Achllle/open-source-rover/Electrical/Latex Docs/Electrical Assembly/Electrical Build.tex

\documentclass{article}
\usepackage[margin=1in]{geometry}
\usepackage{setspace}
\usepackage{graphicx}
\usepackage{subcaption}
\usepackage{amsmath}
\usepackage{color}
\usepackage{hyperref}
\usepackage{multicol}
\usepackage{framed}
\usepackage{xcolor}
\usepackage{wrapfig}
\usepackage{float}
\usepackage{fancyhdr}
\usepackage{verbatim}
\usepackage{wrapfig}
\usepackage{colortbl}
\usepackage{array, booktabs, caption}
\usepackage{makecell}
\usepackage{tcolorbox}
\usepackage{lipsum}

\pagestyle{fancy}
\lfoot{\textbf{Open Source Rover Electrical Assembly}}
\rfoot{Page \thepage}
\lhead{\textbf{\leftmark}}
\rhead{\textbf{\rightmark}}
\cfoot{}
\renewcommand{\footrulewidth}{1.8pt}
\renewcommand{\headrulewidth}{1.8pt}
\doublespacing
\setlength{\parindent}{1cm}

\definecolor{mycolor}{rgb}{0.122, 0.435, 0.698}% Rule colour
\makeatletter
\newcommand{\mybox}[1]{%
  \setbox0=\hbox{#1}%
  \setlength{\@tempdima}{\dimexpr\wd0+13pt}%
  \begin{tcolorbox}[colframe=mycolor,boxrule=0.5pt,arc=4pt,
      left=6pt,right=6pt,top=6pt,bottom=6pt,boxsep=0pt,width=0.95\textwidth]
    #1
  \end{tcolorbox}
}
\makeatother

% Parts list tables
\renewcommand\theadfont{\bfseries}
\newcolumntype{I}{ >{\centering\arraybackslash} m{2cm} }  % part image
\newcolumntype{N}{ >{\centering\arraybackslash} m{3cm} }  % part name
\newcolumntype{Q}{ >{\centering\arraybackslash} m{0.75cm} }  % ref & qty

\newcommand\partimg{\includegraphics[width=2cm,height=1.25cm,keepaspectratio]}

\begin{document}

\title{Open Source Rover: Electrical Assembly Instructions}
\author{Authors: Michael Cox, Eric Junkins, Olivia Lofaro}

\makeatletter         
\def\@maketitle{
\begin{center}	
	\makebox[\textwidth][c]{ }
	{\Huge \bfseries \sffamily \@title }\\[3ex] 
	{\Large \sffamily \@author}\\[3ex] 
	
\end{center}}
\makeatother

\maketitle

\noindent {\footnotesize Reference herein to any specific commercial product, process, or service by trade name, trademark, manufacturer, or otherwise, does not constitute or imply its endorsement by the United States Government or the Jet Propulsion Laboratory, California Institute of Technology. \textcopyright  2018 California Institute of Technology. Government sponsorship acknowledged}

% Introduction
\newpage

\tableofcontents

\newpage

\section{Overview}

First, it is important to examine the components we will use in the rover and understand how both data and power travel through the system. Figure \ref{power} shows how each of the electrical components and boards receives power, and Figure \ref{data} shows how data are sent from each of the electrical systems and what communication protocol it uses. 
\begin{figure}[H]
  	\centering
    	
  	\caption{Electrical Power Overview}
	\label{power}
\end{figure}

\noindent One important thing to note from the above is that there are multiple different voltages in the system. There is the unregulated voltage coming from the battery, 5V regulated coming from the voltage regulator, and the 12V motor voltage which is sent from the motor controllers to the motors. 

\begin{figure}[H]
  	\centering
   	
  	\caption{Electrical Data Overview}
	\label{data}
\end{figure}

\noindent For the data transmission, we use both 3.3V and 5V digital logic systems, analog signals (of varying max voltages), and serial communication between devices. Information on these protocols can be found at:

\begin{itemize}
	\item \href{https://en.wikipedia.org/wiki/Serial_communication}{https://en.wikipedia.org/wiki/Serial\_communication}
	\item \href{https://learn.sparkfun.com/tutorials/analog-vs-digital}{https://learn.sparkfun.com/tutorials/analog-vs-digital}
\end{itemize}

\begin{tabular}[2]{|p{4cm}|p{11cm}|}
	\hline
	\textbf{Part} & \textbf{Description} \\ \hline
	Battery & Provides power to the system. Has an unregulated voltage range of around 11.5V - 16.75V depending on its charge level \\ \hline
	Switch & Mechanical disconnect of the electrical power to the rest of the robot \\ \hline
	Volt Meter & Monitors and displays information such as current draw, voltage level, and power consumption of the robot \\ \hline
	Voltage Regulator & Takes in the unregulated battery voltage and outputs a steady regulated voltage for consumption by electronics. \\ \hline
	Raspberry Pi 3 & Acts as the brains and processing power of the robot \\ \hline
	Arduino Uno & Runs the LED Matrix \\ \hline
	LED Matrix & Gives the robot a display and a personality\\ \hline
	Motor Controllers & Sends voltage signals to the motors telling the motors the direction and speed at which to spin. Reads encoder data \\ \hline
	Encoders & Monitors the position of the motor to give information about speed and position \\ \hline
	Control Board PCB & Custom Printed Circuit Board to manage power and data transmition between electronics components. \\ \hline
\end{tabular}

\subsection{Tools Necessary}

\begin{figure}[H]
  	\centering
   	
  	\caption{}
	\label{elec parts}
\end{figure}

This project assumes you have the tools shown in Figure \ref{elec parts}. These will all be used in the construction and testing/debugging of this project. Most of these can be purchased inexpensively though DigiKey, Amazon, or other retailers. 

\subsection{Component Descriptions}
The following are brief descriptions and basic notes about some of the components we use in this project. For more detailed information on each component, consult the data sheet for that component. 
\subsubsection{Battery}
The battery is used to power all the electrical components and the motors in our rover. The biggest driving factor for battery selection was safety of the battery chemistry while still being able to drive the current and voltage necessary for operation of all the electronics (we'll go into these requirements more later). The recommended battery was chosen because of its Poly Switch and PCB protection. These limit the amount of current that can be pulled from the battery, as well as give protection against things like electrical shorts and overcharging/fully discharging the battery. 
\subsubsection{Voltage Regulators}
As our battery outputs unregulated voltage based on its charge level, voltage regulators are added to give steady DC power to the electronic components. There is a 5V regulator that runs the raspberry pi and the LED matrix, and a 12V regulator that supplies power to the Arduino Uno.
\subsubsection{Raspberry Pi 3}
We selected the Raspberry Pi 3 Model B as the "brain" of the rover. We chose the Pi because it allows users at many levels of programming knowledge to gain familiarity in basic programming concepts without a complicated learning curve. It is also widely used in the maker community, so modifications and additions on the base rover should be easy. The Pi 3 also comes with WiFi and bluetooth modules built into the board and we therefore don't need additional dongles to communicate over WiFi or bluetooth.  This retains all 4 USB ports for addons and modifications to the project.  
\subsubsection{Arduino Uno}
An Arduino Uno runs the LED matrix. The matrix is controlled by a set of GPIO pins from the Arduino and is multiplexed such that these few pins can control all the LEDs. Arduino is designed for these kinds of applications where very high frequency switching of GPIO pins are necessary.  The Uno is better suited for this than the RPi, and offloads some compute power so that the Pi has more capacity to run rover software.
\subsubsection{Control Board PCB}
The custom Printed Circuit Board is designed to help manage the power distribution and data signals for the rover. It takes in battery power, splits it up to each of the voltage regulators and motor controllers which in turn power each of the individual electronics on the robot. It also takes in encoders from the motors and distributes them to the motor controllers, and provides serial UART communication between the RPi and the Motor controllers as well as the Arduino Uno.  The first version of the Open Source Rover required you to run each of these wires by hand; the custom Control Board does much of the routing for you.

\subsubsection{LED Matrix}
The LED Matrix is a 16x32 pixel display that is controlled by the Arduino Uno.  The LED matrix is controllable via software and can be programmed to display anything you like.

\subsubsection{Motors}
Motors cause the actual movement of the robot. There are many types of motors; in this project we will be used brushed DC motors. More information on different types of motors and a link about how brushed DC motors work can be found at the following links:
\begin{itemize}
	\item \href{https://en.wikipedia.org/wiki/Brushed_DC_electric_motor}{https://en.wikipedia.org/wiki/Brushed\_DC\_electric\_motor}
	\item \href{https://en.wikipedia.org/wiki/Electric_motor}{https://en.wikipedia.org/wiki/Electric\_motor}
\end{itemize}

\subsubsection{Encoders}
Encoders give us readings on the position and speed of motors as they spin. There are two types of encoders in this project: absolute and quadrature. An absolute encoder is used to get the position of the motor on a fixed scale such that you always know the absolute position of the motor even after power cycling the system. Absolute encoders will usually have one output, which will either be a PWM digital signal or an analog signal. Each of these signals will have a specific reading corresponding to where the motor currently is on the fixed position scale. Absolute encoders are typically more expensive than their quadrature encoder counterparts, which will sense position only relative to the last time the power was cycled or the signal was reset. Quadrature encoders use two digital signals and look at the difference between the signals to sense movement. More information about quadrature encoders can be found at: 

\begin{itemize}
	\item \href{http://www.dynapar.com/Technology/Encoder_Basics/Quadrature_Encoder/}{http://www.dynapar.com/Technology/Encoder\_Basics/Quadrature\_Encoder/}  
\end{itemize}

\noindent In this project, we use absolute encoders on the corner wheels to get absolute measurements on where the corner wheels are turned/pointed. We use quadrature encoders at each of the driving wheels to get speed measurements.

\section{Powering Components}
This section will go through the process of powering each of the components from the battery. During this project you will need to cut, strip, and solder wires to extend and split electrical connections. It is important to understand how to do this safely so that you are protecting your system from electrical shorts. Below are a few quick links on these skills, however it is crucial that you fully understand these processes before proceeding. 

\begin{itemize}
	\item \href{https://learn.sparkfun.com/tutorials/working-with-wire/how-to-strip-a-wire}{https://learn.sparkfun.com/tutorials/working-with-wire/how-to-strip-a-wire}
	\item \href{https://www.wikihow.com/Splice-Wire}{https://www.wikihow.com/Splice-Wire}
	\item \href{https://www.youtube.com/watch?v=Y8wjv6lj5KU}{https://www.youtube.com/watch?v=Y8wjv6lj5KU}
\end{itemize}

\noindent \textbf{**Note** Please read through this entire section and understand it fully before starting to connect devices and electronics together. }

\subsection{Switch, Volt Meter, and Control Board}

\mybox{
There are a couple of \textbf{very important} things to be aware of as you are making these connections, as with any project where you are working with batteries or electrical current:
\newline
\noindent \textbf{THE BATTERY IS LIVE AT ALL TIMES}. This means that at any point, if the two terminals of the battery come in contact they will cause an electrical short \textbf{which could be very dangerous}. This may trigger the protection circuit in the battery that we chose and prevent extensive damage, but we do not want to rely on that for safety. \textbf{Make sure to keep the battery terminals of the +V and GND separated at all times with no possibility of contact.}
\newline
\noindent The battery connectors will only fit together one way. That means you have to make sure your connections are correct the first time when soldering them in: make sure to verify this before connecting anything to the battery.
\newline
\noindent The switch we use is a Single Pole - Single Throw switch. This means that either the two terminals are connected together in one switch position or there is a physical disconnect when the switch is in the other position. Make sure to test the switch and know which are its ON and OFF positions previous to connecting it to anything.  An easy way to test the switch is to use the 'Diode' setting on your Digital Multimeter (DMM).
\newline
\noindent  It is extremely important to plug the battery in the correct direction into the volt meter as well, as plugging it in backwards (even for an instant) could damage or destroy the volt meter. 
}

\begin{table}[H]
	\centering
	\arrayrulecolor{lightgray}
	\sffamily\footnotesize
	\captionsetup{font={sf,bf}}
	\caption{Parts Necessary}
	\begin{tabular}{|N|Q|Q|I|N|Q|Q|I|}
			\hline
			\thead{Item} & \thead{Ref} & \thead{Qty} & \thead{Image} & \thead{Item} & \thead{Ref} & \thead{Qty} & \thead{Image} \\
			\hline
			Battery & E36 & 1 & \partimg{../../../images/components/Electronics/E36.png} & Tamiya Connectors & E35 & 1 & \partimg{../../../images/components/Electronics/E35.png} \\ \hline
			12 AWG Wire (Black) & X7 & 1 & \partimg{../../../images/components/Wiring/X7.png} & 12 AWG Wire (Red) & X8 & 1 & \partimg{../../../images/components/Wiring/X8.png} \\ \hline
			Battery Charger & E41 & 1 & \partimg{../../../images/components/Electronics/E41.png} & & & & \\ \hline
	\end{tabular}
\end{table}

\noindent Using the Tamiya connectors, connect the battery to the switch and then the volt meter according to Figure \ref{battery_wiring}. The Tamiya connectors allow you to disconnect the battery from the rest of the system so you can recharge the battery. 

\begin{figure}[H]
  	\centering
    	
 	\caption{Connecting the Battery to switch and board}
	\label{battery_wiring}
\end{figure}

\section{Connecting Data Cables}

\textbf{**NOTE: Before proceeding, you need to have completed the assembly of the custom PCB board and populated all the components.  If you have not yet done so, build the Control Board now by following the document at \href{https://github.com/nasa-jpl/open-source-rover/blob/master/Electrical/PCB Assembly.pdf}{/Electrical/PCB Assembly.pdf}.}

\begin{table}[H]
	\centering
	\arrayrulecolor{lightgray}
	\sffamily\footnotesize
	\captionsetup{font={sf,bf}}
	\caption{Parts Necessary}
	\begin{tabular}{|N|Q|Q|I|N|Q|Q|I|}
			\hline
			\thead{Item} & \thead{Ref} & \thead{Qty} & \thead{Image} & \thead{Item} & \thead{Ref} & \thead{Qty} & \thead{Image} \\
			\hline
			Rectangular 6P 1x6 Jumper Cable  & E26 & 1 & \partimg{../../../images/components/Electronics/E26.png} & USB Power Cable & E28 & 1 & \partimg{../../../images/components/Electronics/E28.png} \\ \hline
			Rectangular 40P 2x20 Ribbon Cable & E29 & 1 & \partimg{../../../images/components/Electronics/E29.png} & Rectangular 16P Ribbon Cable & E30 & 1 & \partimg{../../../images/components/Electronics/E30.png} \\ \hline
			USB to TTL Serial Adapter & E48 & 1 & \partimg{../../../images/components/Electronics/E48.png} & & & & \\ \hline
	\end{tabular}
\end{table}

Next, we will next plug in all the cables that allow the various devices to communicate with each other. 

\begin{enumerate}
	\item Connect the \textbf{E26} cable from the J10 Connector on the Control Board to the J5 Connector on the Arduino Shield
	\item Connect the \textbf{E30} 16 Position ribbon cable from the J1 Connector to the INPUT Connector on the LED Matrix
	\item Connect the \textbf{E48} TTL serial to USB cable from any USB port on the Raspberry Pi to the 6 Position headers at J8.  The pinout should match the table below (see Figure \ref{usb_ttl_serial}):
\end{enumerate}

\centering
\begin{tabular}{|N|N|}
	\hline
	\textbf{Control Board PCB J8 pin} & \textbf{TTL Serial cable wire color} \\ \hline
	1. GND & Black \\ \hline
	2. N/A & Not Connected \\ \hline
	3. 5V & Red \\ \hline
	4. TxD & Green \\ \hline
	5. RxD & White \\ \hline
	6. N/A & Not Connected \\ \hline
\end{tabular}

\begin{figure}[H]
	\centering
	\begin{minipage}[b]{0.45\textwidth}
		
	\end{minipage}
	\caption{USB / TTL Serial Cable Connection}
	\label{usb_ttl_serial}
\end{figure}

\section{Connecting Motors/Encoders}

Next, we will connect the motors and encoders to the RoboClaw motor controllers. For each of the 10 motors you will need to connect motor power as well as the encoders. This means that there will be close to 60 wires traveling between the motor controllers and the motors/encoders, so it is very important to try to keep your wires organized and bundled together well. Below is some information about strain relief and using wire braid in your electronics systems.  See these links and Figures \ref{wiring1} and \ref{wiring2} for examples.

\begin{itemize}
	\item \href{https://www.techopedia.com/definition/2301/strain-relief}{https://www.techopedia.com/definition/2301/strain-relief}
	\item \href{https://www.youtube.com/watch?v=FeCs98TSsYQ}{https://www.youtube.com/watch?v=FeCs98TSsYQ}
\end{itemize}

\begin{figure}[H]
  	\centering
  	\begin{minipage}[b]{0.34\textwidth}
    		
  	\end{minipage}
  	\hfill
  	\begin{minipage}[b]{0.29\textwidth}
    		
  	\end{minipage}
    	\hfill
  	\begin{minipage}[b]{0.30\textwidth}
    		
  	\end{minipage}
  	\caption{}
	\label{wiring1}
\end{figure}

\mybox{
An example of how we routed our wiring is shown by Figure \ref{wiring1}. It is important to give strain relief in the cable as you are routing it through, as well as to give extra wiring for the locations that can move. In addition, Figure \ref{wiring2} shows how we routed the wires through the rocker-bogie, and then from the rocker-bogie into the main body. Try to pick locations that reduce strain on the wires as the robot legs move when you are routing wires into the body.
}

\begin{figure}[H]
 	\centering
  	\begin{minipage}[b]{0.48\textwidth}
		
  	\end{minipage}
  	\hfill
  	\begin{minipage}[b]{0.42\textwidth}
    		
  	\end{minipage}
	\caption{Serial signal routing}
	\label{wiring2}
\end{figure}

\begin{table}[H]
	\centering
	\arrayrulecolor{lightgray}
	\sffamily\footnotesize
	\captionsetup{font={sf,bf}}
	\caption{Parts Necessary}
	\begin{tabular}{|N|Q|Q|I|N|Q|Q|I|}
			\hline
			\thead{Item} & \thead{Ref} & \thead{Qty} & \thead{Image} & \thead{Item} & \thead{Ref} & \thead{Qty} & \thead{Image} \\
			\hline
			20AWG Wire (Black) & X2 & N/A & \partimg{../../../images/components/Wiring/X2.png} & 20AWG Wire (Red) & X1 & N/A & \partimg{../../../images/components/Wiring/X1.png} \\ \hline
			30AWG Wire (White) & X3 & N/A & \partimg{../../../images/components/Wiring/X3.png} & 30AWG Wire (Blue) & X4 & N/A & \partimg{../../../images/components/Wiring/X4.png} \\ \hline
			30AWG Wire (Yellow) & X5 & N/A & \partimg{../../../images/components/Wiring/X5.png} & 30AWG Wire (Green) & X6 & N/A & \partimg{../../../images/components/Wiring/X6.png} \\ \hline
			3 Pin Micro Connector & E40 & 4  & \partimg{../../../images/components/Electronics/E40.png} & Wire Braid & E42 & 1 & \partimg{../../../images/components/Electronics/E42.png} \\ \hline
			Heat Shrink Tubing & E44 & 1 & \partimg{../../../images/components/Electronics/E44.png} & & & & \\ \hline
	\end{tabular}
\end{table}

\noindent The below table and figure shows an approximate amount of length of wire you will need to reach each of the motors, based on how we think is best to route the wiring through the suspension system. Cut these lengths and strip both ends of the wires. 

\begin{tabular}[3] {| p{2cm} | p{7cm} | p{4cm} |}
	\hline
	\textbf{Section} & \textbf{Wires Needed} & \textbf{Length [inches]}  \\ \hline
	\textcolor{blue}{A} & \textcolor{blue}{2x 20AWG \& 4x 30AWG} & \textcolor{blue}{35} \\ \hline
	\textcolor{cyan}{B} & \textcolor{cyan}{2x 20AWG \& 4x 30AWG} & \textcolor{cyan}{28} \\ \hline
	\textcolor{green}{C} & \textcolor{green}{2x 20AWG \& 4x 30AWG} & \textcolor{green}{48} \\ \hline
	\textcolor{red}{D} & \textcolor{red}{2x 20AWG \& 3x 30AWG} & \textcolor{red}{20} \\ \hline
	\textcolor{magenta}{E} & \textcolor{magenta}{2x 20AWG \& 3x 30AWG} & \textcolor{magenta}{32} \\ \hline
\end{tabular}

\begin{figure}[H]
 	\centering
	
 	\caption{Wire lengths}
	\label{wire lengths}
\end{figure}

\subsection{Drive Motors}
We will begin with the drive motors (the 6 motors that are directly connected to each drive wheel). Make sure to look at which RoboClaw corresponds to which motors that that RoboClaw controls. It is important that this ordering is preserved. Figure \ref{motorID} shows the motor pinout for the motors for the drive system. You will be wiring each of these to the terminal blocks on the control board. One method of doing this is to cut off the 6 pin connector from the motor and solder directly to the wires there. Another way is to add your own connector if you wish to be able to change the motor out easier in the future.

\begin{figure}[H]
 	\centering
	
 	\caption{RoboClaw - Motor Assignments}
	\label{motorID}
\end{figure}

The terminal blocks that correspond to the drive motors are connectors J17-J22. You will see them labeled on the control board corresponding to which motor it should connect to\footnote{Make sure you are using a REV-E or newer board.  There was an initial release of board files that had the silkscreen reversed from left-right for all motors (drive and corner). If you have a REV-D or earlier board, the silkscreen may have these labels backwards.}.

\mybox{Each of the terminal blocks are identical for the drive motors; pay attention to the silkscreen to know which screw terminal to plug the wire into. The terminal block position on the board will correspond roughly with which motor it goes to on the robot, ie. the J17 connector is in the front-right of the board when installed in the robot, and connects to the front-right drive wheel. }

\begin{tabular}[3] {| l | l | l |}
	\hline
	\textbf{Control Board Label} & \textbf{Motor Wire Color} & \textbf{Signal} \\ \hline
	Mx+ & Red & Motor + \\ \hline
	Mx- & Black & Motor - \\ \hline
	GND & Green & Ground \\ \hline
	+5V & Blue & Encoder Power \\ \hline
	ENxA & Yellow & Encoder signal A \\ \hline
	ENxB & White & Encoder signal B \\ \hline
	\hline
\end{tabular}

\subsection{Corner Motors/Encoders}
The big difference between the corner motors and drive motors is that the corners use absolute encoders. The absolute encoders are separate from the motor and so we have to do a little bit of work to get them to interface with the motor controllers. The corner motors only have the two connections to the physical motor: the (+) and (-) going to the top of the motor. However, you must also hook up the absolute encoder. When plugged into the encoder, the 3-pin Micro connector will have 3 wires coming out of it, shown in Figure \ref{3pin}.

\bigskip 

\begin{figure}[H]
 	\centering
	
 	\caption{3-pin Micro connector}
	\label{3pin}
\end{figure}

\bigskip
\begin{tabular}[3] {| p{3cm} | p{7cm} | p{3cm} | }
	\hline
	\textbf{Pin} & \textbf{Description} & \textbf{Color} \\ \hline
	1 & +5V DC Power & \textcolor{orange}{\textbf{Orange}} \\ \hline
	2 & 0-5V Analog & \textcolor{blue}{\textbf{Blue}} \\ \hline
	3 & Ground & \textcolor{brown}{\textbf{Brown}} \\ \hline
\end{tabular}

\bigskip

Similar to the drive motors, connect each of the corner motors and encoders to its corresponding terminal block (J23-26 on the control board). Below is the pinout for how to connect the encoders: \textbf{**Note** These are NOT the same color and pinout as the drive motors!}

\bigskip

\begin{tabular}[3] {| l | l | l |}
	\hline
	\textbf{Control Board Label} & \textbf{Motor Wire Color} & \textbf{Signal} \\ \hline
	Mx+ & Red & Motor + \\ \hline
	Mx- & Black & Motor - \\ \hline
	GND & Brown & Ground \\ \hline
	+5V & Orange & Encoder Power \\ \hline
	ENx & Blue & 0-5V Analog Signal \\ \hline
	\hline
\end{tabular} 

\bigskip 
With that, all of the electrical wiring on your rover has been completed! You can now move onto the calibration process!  (see \href{https://github.com/nasa-jpl/open-source-rover/blob/master/Electrical/Calibration.pdf}{/Electrical/Calibration.pdf})

\end{document}
