Achllle/open-source-rover/mechanical/mechanical_integration/cad/3d_printed_parts/Head Assembly.SLDASM

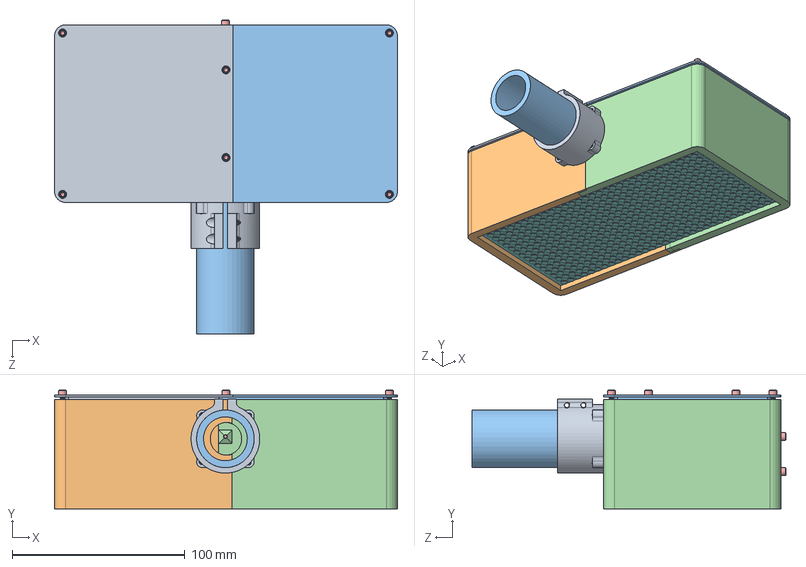
[picture p1: CAD file, 2021-06-14]
mechanical/mechanical_integration/cad/3d_printed_parts/Head Assembly.SLDASM
198.7 x 68.9 x 181.9 mm
Head left back
Head left side
Head right back
Head right side
4-40_SHCS x 12
logic shifter board
hex_nut x 4
LED Matrix
PVC Clamping Hub
6-32_SHCS x 4
3in PVC Pipe
