Achllle/open-source-rover/mechanical/mechanical_integration/cad/subassemblies/body/Diff Pivot Swivel.SLDASM

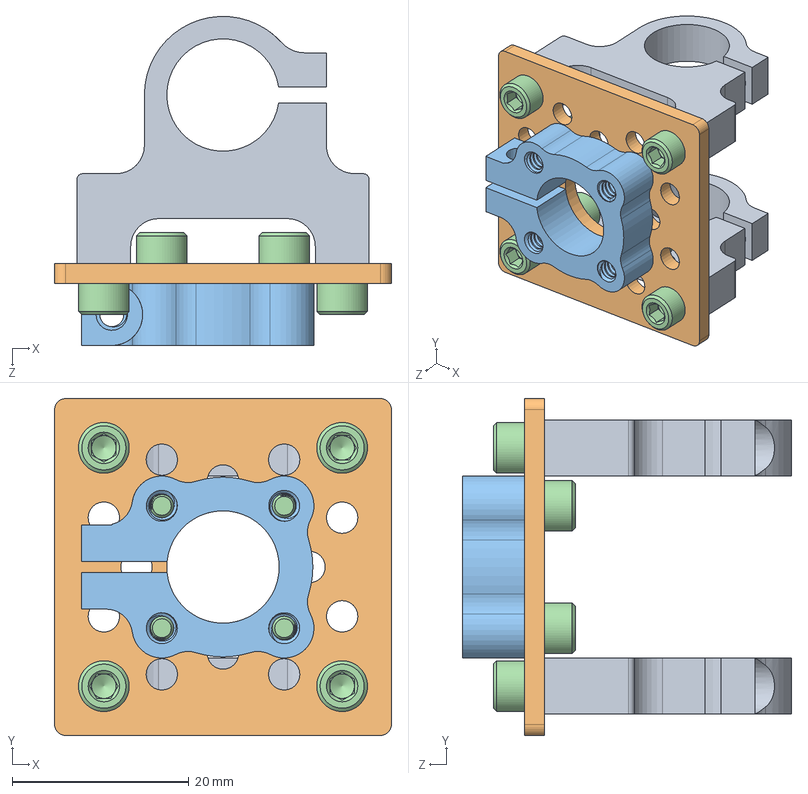
[picture p2: CAD file, 2021-06-14]
mechanical/mechanical_integration/cad/subassemblies/body/Diff Pivot Swivel.SLDASM
38.1 x 38.1 x 37.2 mm
1 Hole Pattern Bracket
6-32_SHCS x 8
