Achllle/open-source-rover/mechanical/mechanical_integration/cad/subassemblies/body/mechanical_parts/0.5 Pillow Bearing Block.SLDASM

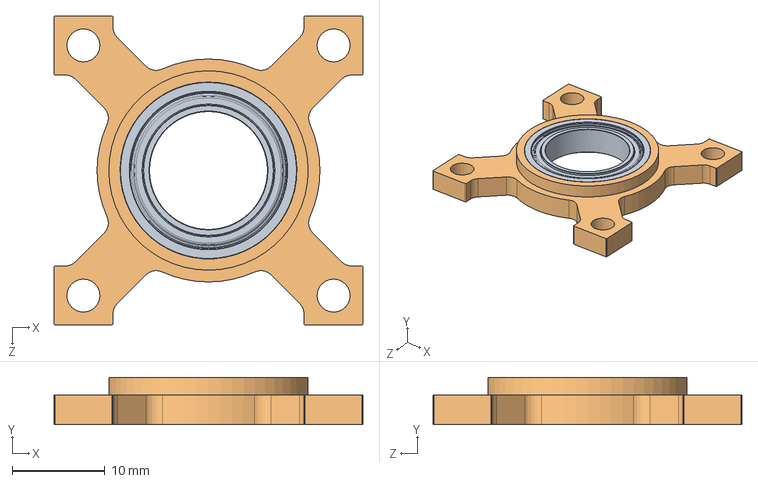
[picture p3: CAD file, 2021-06-14]
mechanical/mechanical_integration/cad/subassemblies/body/mechanical_parts/0.5 Pillow Bearing Block.SLDASM
33.3 x 5.08 x 33.3 mm
0.5 Bearing
0.5 Bearing Block
