Achllle/open-source-rover/mechanical/mechanical_integration/cad/subassemblies/differential_pivot/Diff Pivot Bottom.SLDASM

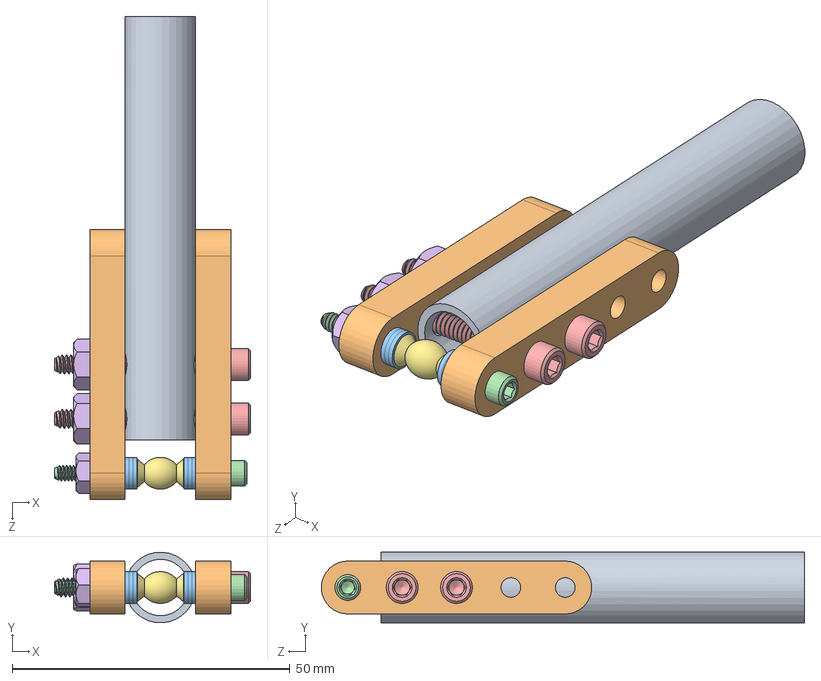
[picture p4: CAD file, 2021-06-14]
mechanical/mechanical_integration/cad/subassemblies/differential_pivot/Diff Pivot Bottom.SLDASM
35.3 x 12.7 x 86.9 mm
3 inch Aluminum Rod
5 Hole Aluminum Beam x 2
4-40 Washer x 6
4-40_SHCS
6-32_SHCS x 2
hex_nut x 3
Ball bearing
