Achllle/open-source-rover/mechanical/mechanical_integration/cad/subassemblies/wheel_assembly/mechanical_parts/Wheel.SLDASM

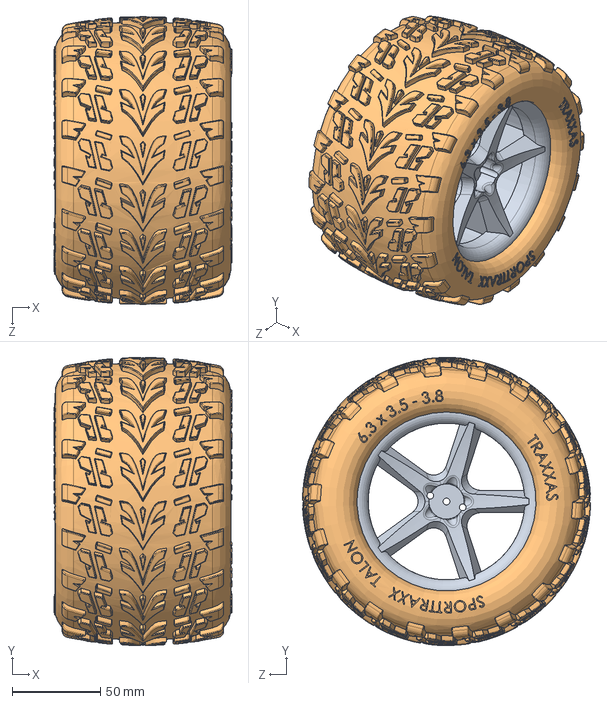
[picture p5: CAD file, 2021-06-14]
mechanical/mechanical_integration/cad/subassemblies/wheel_assembly/mechanical_parts/Wheel.SLDASM
101.0 x 163.5 x 163.6 mm
Wheel Rim
Wheel Tire
