Achllle/open-source-rover/mechanical/wheel_assembly/cad/mechanical_parts/servocity-hub-545619assembly.SLDASM

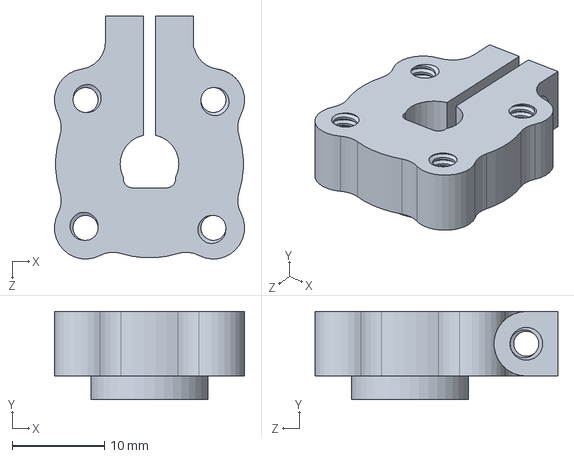
[picture p6: CAD file, 2021-06-14]
mechanical/wheel_assembly/cad/mechanical_parts/servocity-hub-545619assembly.SLDASM
20.6 x 9.53 x 26.3 mm
