Achllle/open-source-rover/mechanical/mechanical_integration/cad/subassemblies/differential_pivot/Diff Pivot Top.SLDASM

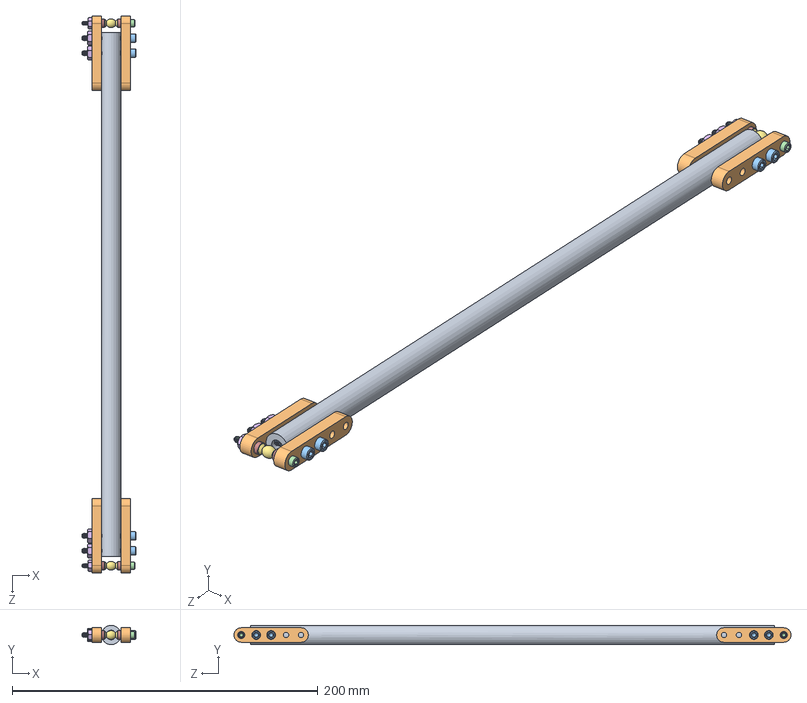
[picture p7: CAD file, 2021-06-14]
mechanical/mechanical_integration/cad/subassemblies/differential_pivot/Diff Pivot Top.SLDASM
35.3 x 12.7 x 364.3 mm
13.5 Inch Aluminum Rod
5 Hole Aluminum Beam x 4
6-32_SHCS x 4
4-40_SHCS x 2
4-40 Washer x 12
hex_nut x 6
Ball bearing x 2
