Achllle/open-source-rover/mechanical/mechanical_integration/cad/subassemblies/wheel_assembly/mechanical_parts/gobilda-32mm-motor-clamp-1401-0043-0032.sldasm

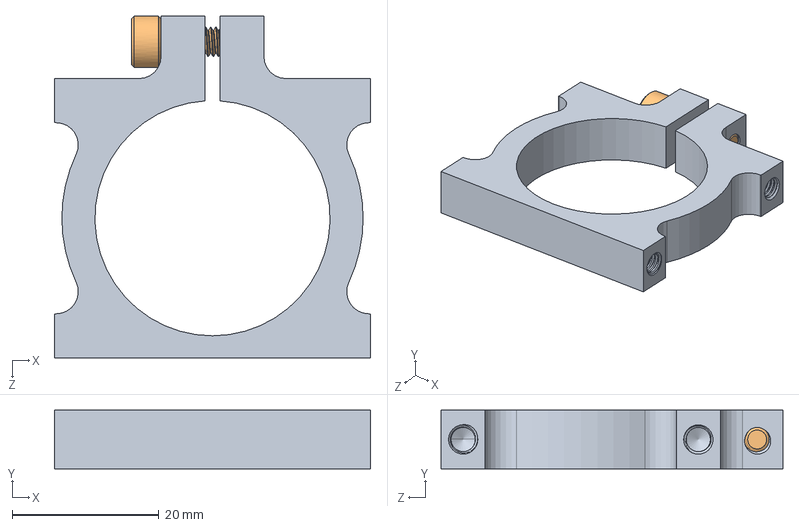
[picture p8: CAD file, 2021-06-14]
mechanical/mechanical_integration/cad/subassemblies/wheel_assembly/mechanical_parts/gobilda-32mm-motor-clamp-1401-0043-0032.sldasm
43.0 x 8.00 x 46.5 mm
2800-0004-0014_90128A207
