Achllle/open-source-rover/mechanical/mechanical_integration/cad/subassemblies/wheel_assembly/mechanical_parts/gobilda-to-actobotics-bracket-1206-0016-0004.SLDASM

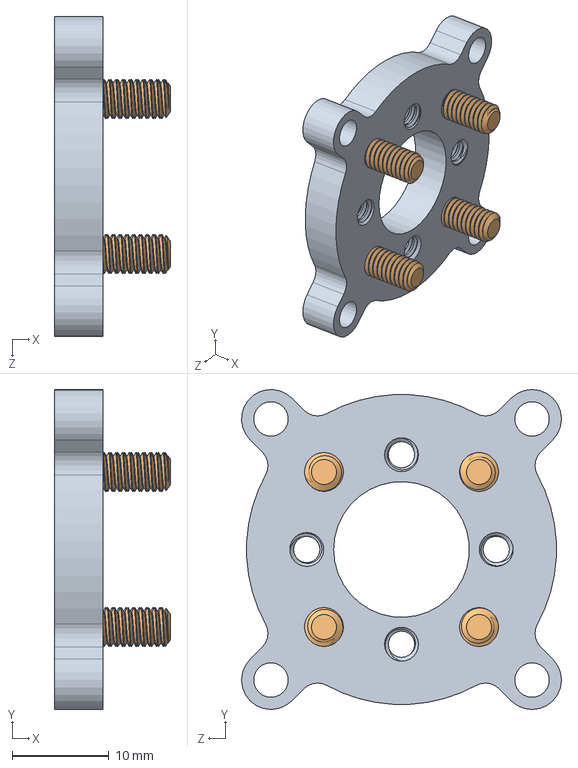
[picture p9: CAD file, 2021-06-14]
mechanical/mechanical_integration/cad/subassemblies/wheel_assembly/mechanical_parts/gobilda-to-actobotics-bracket-1206-0016-0004.SLDASM
12.0 x 33.0 x 33.0 mm
2800-0004-0008_90128A207 x 4
