Achllle/open-source-rover/mechanical/corner_steering/cad/mechanical_parts/flat_4_channel.SLDPRT

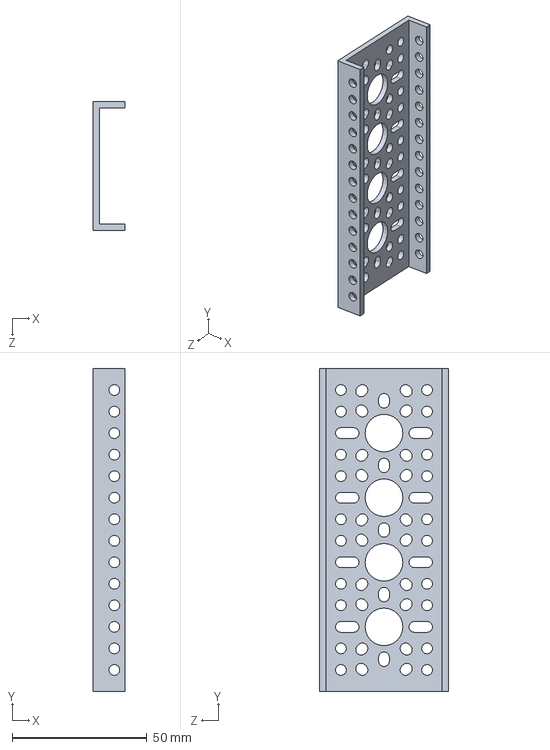
[picture p10: CAD file, 2021-06-14]
mechanical/corner_steering/cad/mechanical_parts/flat_4_channel.SLDPRT
12.0 x 120.0 x 48.0 mm
