Achllle/open-source-rover/mechanical/mechanical_integration/cad/mechanical_parts/actobotics-gobilda-adaptor-0032-006.SLDPRT

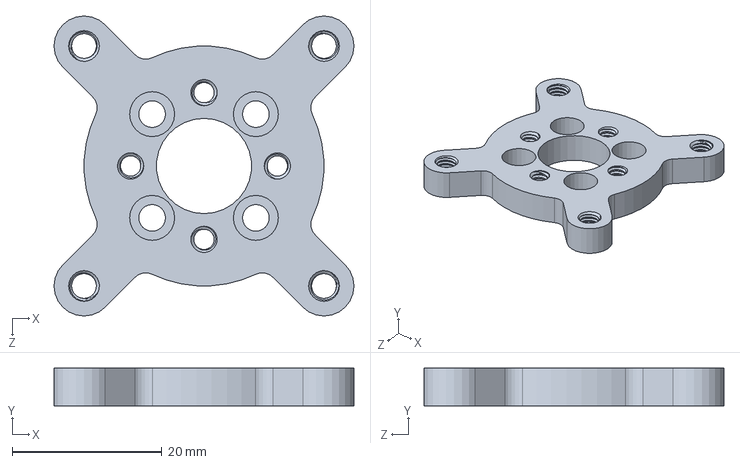
[picture p11: CAD file, 2021-06-14]
mechanical/mechanical_integration/cad/mechanical_parts/actobotics-gobilda-adaptor-0032-006.SLDPRT
40.0 x 5.00 x 40.0 mm
