Achllle/open-source-rover/mechanical/rocker_bogie/cad/mechanical_parts/3 Aluminum Channel.SLDPRT

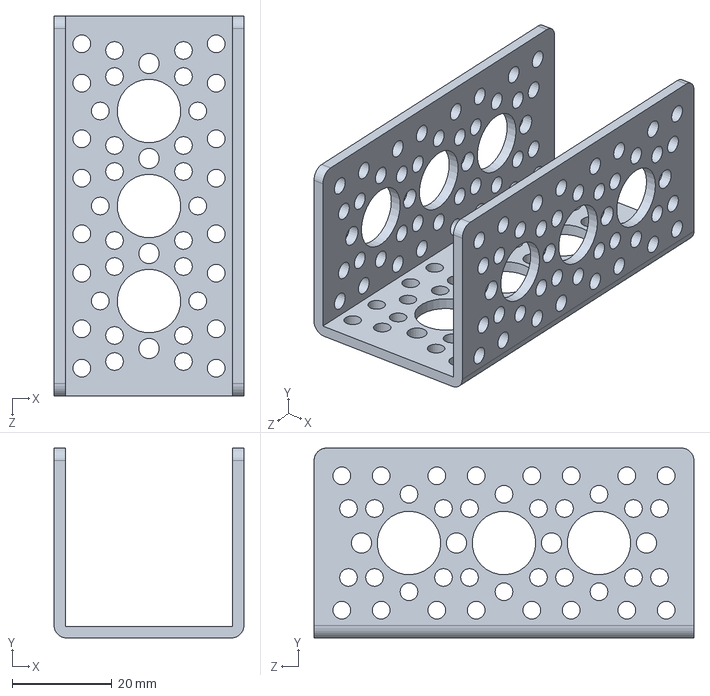
[picture p12: CAD file, 2021-06-14]
mechanical/rocker_bogie/cad/mechanical_parts/3 Aluminum Channel.SLDPRT
38.1 x 38.1 x 76.2 mm
