Achllle/open-source-rover/mechanical/corner_steering/cad/mechanical_parts/90deg_gobilda_connector.SLDPRT

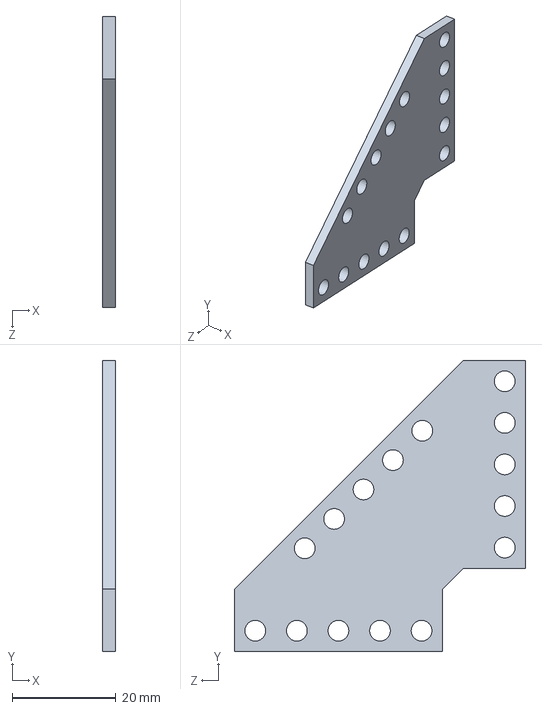
[picture p13: CAD file, 2021-06-14]
mechanical/corner_steering/cad/mechanical_parts/90deg_gobilda_connector.SLDPRT
2.50 x 56.0 x 56.0 mm
