Achllle/open-source-rover/mechanical/mechanical_integration/cad/subassemblies/wheel_assembly/mechanical_parts/1206-0016-0004.sldprt

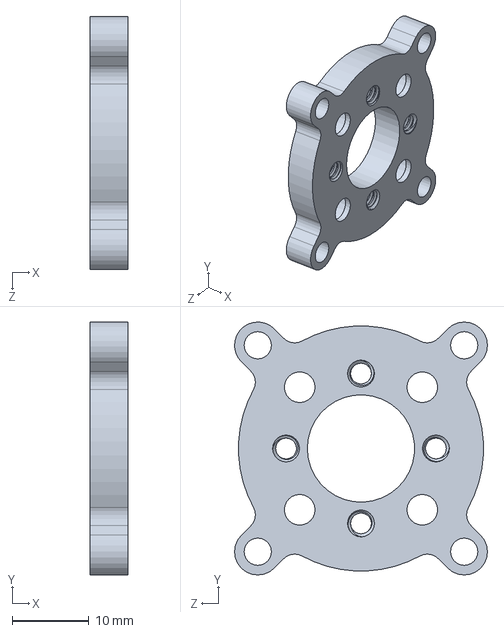
[picture p14: CAD file, 2021-06-14]
mechanical/mechanical_integration/cad/subassemblies/wheel_assembly/mechanical_parts/1206-0016-0004.sldprt
5.00 x 33.0 x 33.0 mm
