Achllle/open-source-rover/mechanical/rocker_bogie/cad/mechanical_parts/6-32_SHCS.SLDPRT

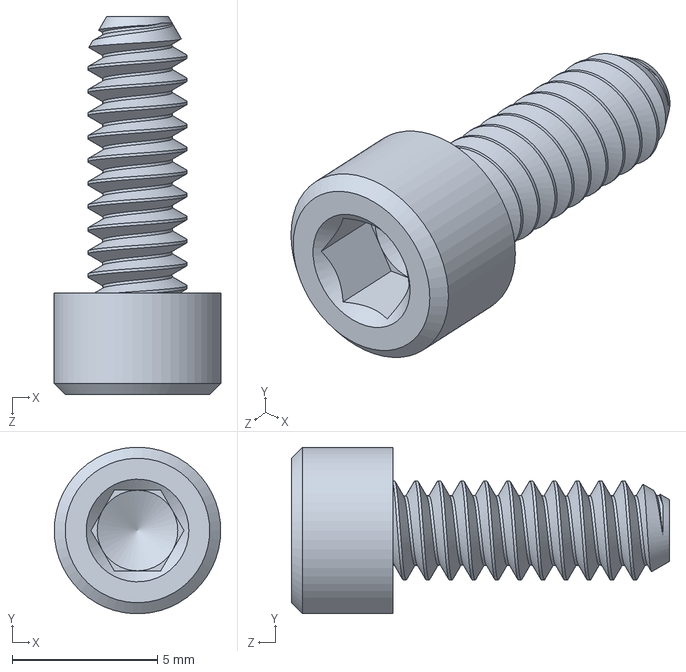
[picture p15: CAD file, 2021-06-14]
mechanical/rocker_bogie/cad/mechanical_parts/6-32_SHCS.SLDPRT
5.74 x 5.73 x 13.0 mm
