Achllle/open-source-rover/mechanical/rocker_bogie/cad/mechanical_parts/.5in Collared Clamp.SLDPRT

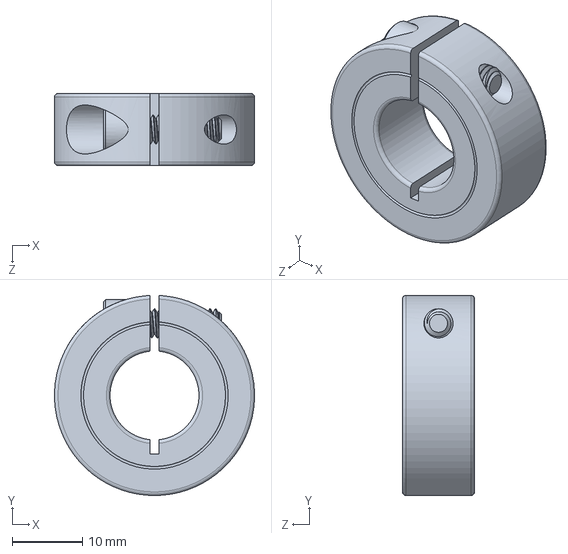
[picture p16: CAD file, 2021-06-14]
mechanical/rocker_bogie/cad/mechanical_parts/.5in Collared Clamp.SLDPRT
28.6 x 28.6 x 10.3 mm
