Achllle/open-source-rover/mechanical/rocker_bogie/cad/mechanical_parts/14_aluminum_channel.SLDPRT

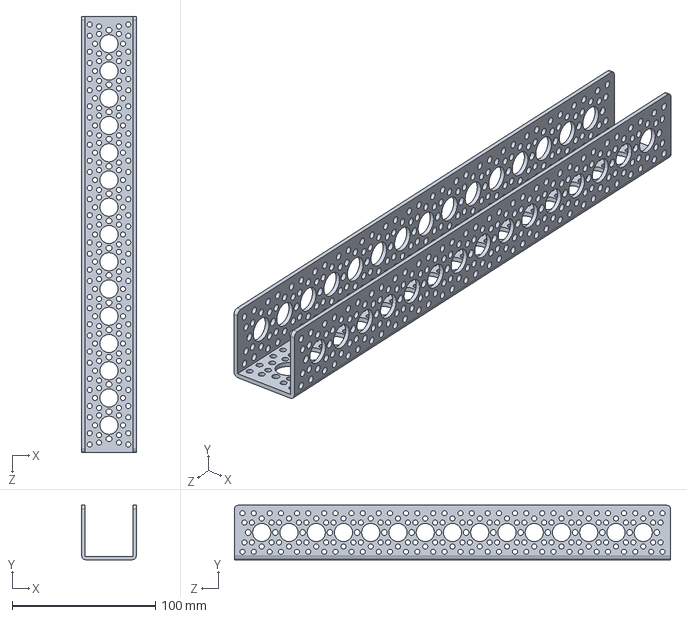
[picture p17: CAD file, 2021-06-14]
mechanical/rocker_bogie/cad/mechanical_parts/14_aluminum_channel.SLDPRT
38.1 x 38.1 x 304.8 mm
