Achllle/open-source-rover/mechanical/rocker_bogie/cad/mechanical_parts/9_aluminum_channel.SLDPRT

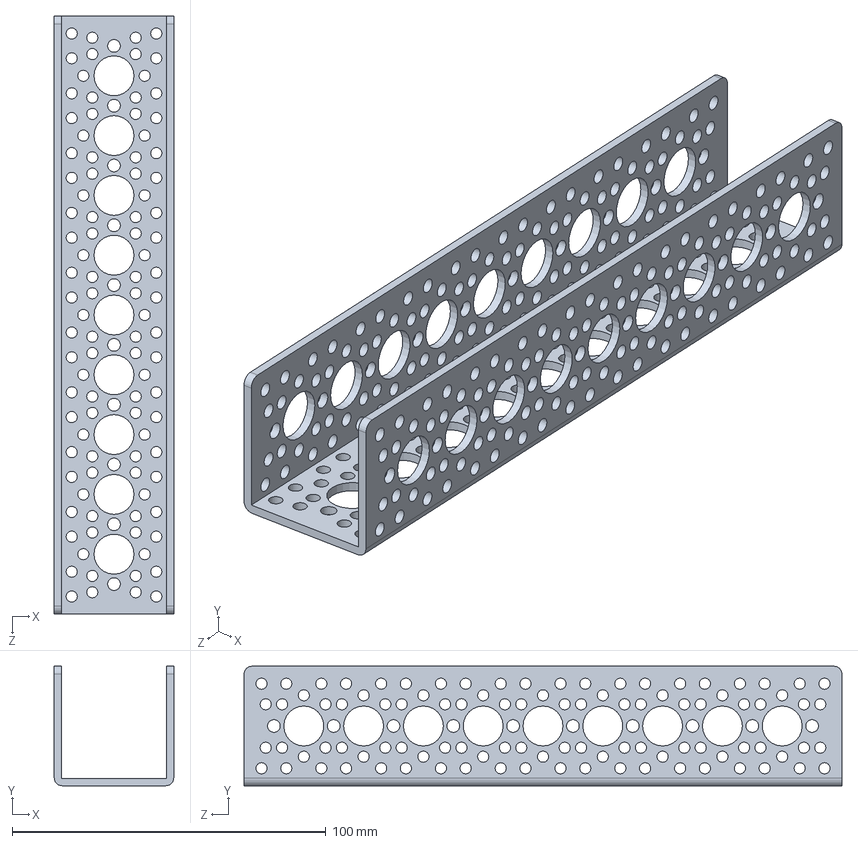
[picture p18: CAD file, 2021-06-14]
mechanical/rocker_bogie/cad/mechanical_parts/9_aluminum_channel.SLDPRT
38.1 x 38.1 x 190.5 mm
