Achllle/open-source-rover/mechanical/rocker_bogie/cad/mechanical_parts/6-32_L0_25 Spacer.SLDPRT

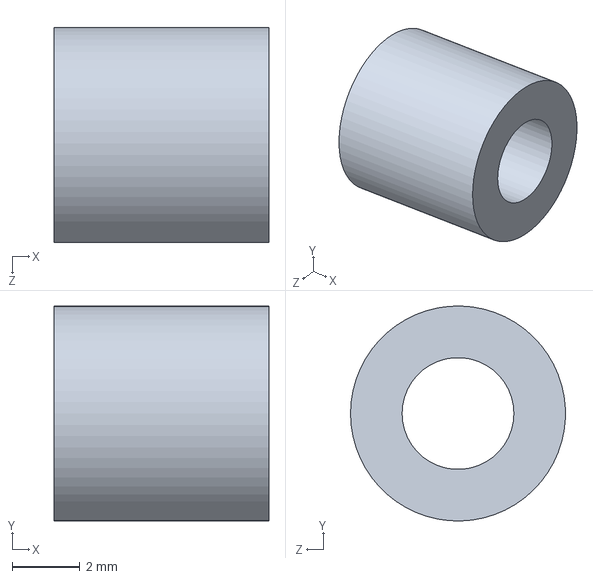
[picture p19: CAD file, 2021-06-14]
mechanical/rocker_bogie/cad/mechanical_parts/6-32_L0_25 Spacer.SLDPRT
6.35 x 6.35 x 6.35 mm
