Achllle/open-source-rover/(list of files, cad)

Other CAD files:
mechanical/corner_steering/cad/mechanical_parts/corner_motor/545440.SLDPRT
mechanical/corner_steering/cad/mechanical_parts/corner_motor/545600 assembly.SLDASM
mechanical/corner_steering/cad/mechanical_parts/corner_motor/545600.SLDPRT
mechanical/corner_steering/cad/mechanical_parts/corner_motor/615194_Gear Blank.SLDPRT
mechanical/corner_steering/cad/mechanical_parts/corner_motor/615310_Gear Blank.SLDPRT
mechanical/corner_steering/cad/mechanical_parts/corner_motor/632110_90128A121.SLDPRT
mechanical/corner_steering/cad/mechanical_parts/corner_motor/632114_90128A121.SLDPRT
mechanical/rocker_bogie/cad/mechanical_parts/0.5 Nylon Plastic Washer.SLDPRT
mechanical/rocker_bogie/cad/mechanical_parts/6-32 Washer.SLDPRT
mechanical/rocker_bogie/cad/mechanical_parts/hex_nut.sldprt
