Achllle/open-source-rover/(commit log)

2020-07-02 Create new parts X7 and X8 for 12AWG wiring, copy over X1 and X2 pics because about the same
2020-07-02 Add X7 and X8 to parts_list_reference, need to run script on ubuntu machine...
    [parts_list_reference.csv]
2021-06-13 Import servocity corner servo
    [545440.SLDPRT, 545600 assembly.SLDASM, 545600.SLDPRT, 615194_Gear Blank.SLDPRT, 615310_Gear Blank.SLDPRT, 632110_90128A121.SLDPRT, 632114_90128A121.SLDPRT]
2021-06-14 Unfinished servo switch, most of the work
    [.5in Collared Clamp.SLDPRT, 0.5 Nylon Plastic Washer.SLDPRT, 0.5 Pillow Bearing Block.SLDASM, 1206-0016-0004.sldprt, 14_aluminum_channel.SLDPRT, 3 Aluminum Channel.SLDPRT, 545600 assembly.SLDASM, 6-32 Washer.SLDPRT]
